ToshiyukiSano/iot-kicad-esp32c3-current-monitor/examples/current-monitor/hardware/README.md

# 回路・PCBデータの格納先

Claude CodeがUbuntuで作成した `.kicad_sch`、`.kicad_pcb`、`.kicad_pro`、専用 `.kicad_sym`、`.pretty`、ライブラリテーブル等をコピーする場所です。

**現時点では実ファイルが未提供**のため同梱していません。`scripts/import_local_project.sh` で取り込み、別環境で開けることを確認してください。Gerber/製造データはまだ作らないでください。
