ToshiyukiSano/iot-kicad-esp32c3-current-monitor/examples/current-monitor/firmware/README.md

# Arduinoスケッチの格納先

Claudeが作成した `firmware/current_monitor/current_monitor.ino` は、ユーザーのUbuntu上に存在すると報告されていますが、この会話には実ファイルが提供されていません。実際にコンパイル済みと確認できるまでは**未検証コード**と表示してください。

`bash scripts/import_local_project.sh ~/Projects/current-monitor` を使用すると、存在するファイルだけをここへコピーできます。
