ToshiyukiSano/iot-kicad-esp32c3-current-monitor/examples/current-monitor/hardware/final-check-from-claude.md

# current-monitor 製造前最終確認（2026-11-01）

対象：`current-monitor.kicad_pcb` / `current-monitor.kicad_sch`（配線は変更していない。U1 の 3D モデル情報のみ追加）

## 1. 検査結果

| 項目 | 結果 | 方法 |
|---|---|---|
| ERC | エラー 0 / 警告 0 | `kicad-cli sch erc --severity-all` |
| DRC | 違反 0 / 未接続 0 | `kicad-cli pcb drc --severity-all`（除外設定なし） |
| 回路図⇔PCB 整合 | Footprint errors 0 | DRC `--schematic-parity` |
| XIAO ピン配置 | 14/14 一致（位置誤差 0.004 mm） | U1 パッド座標 ⇔ Seeed 公式 XIAO ESP32C3 v1.3 PCB の同位置パッドのネット名 ⇔ シンボルのピン名 ⇔ 本PCBのネット |
| 3D モデル追加による配線・配置への影響 | なし | 追加前後で配線・ビア・部品位置のハッシュ一致 |
| D2 | DNP 維持（回路図・PCB・BOM） | |

### XIAO ピン照合

| U1 パッド | Seeed PCB ネット | シンボル | 本PCBネット |
|---|---|---|---|
| 1 | D0 | D0/A0/GPIO2 | D0_GPIO2 |
| 2 | D1 | D1/A1/GPIO3 | ADC_A1 |
| 3–6 | D2–D5 | D2–D5 | D2_GPIO4 … D5_GPIO7 |
| 7 | TX_D6 | D6/TX/GPIO21 | D6_GPIO21 |
| 8 | RX_D7 | D7/RX/GPIO20 | D7_GPIO20 |
| 9–11 | D8–D10 | D8–D10 | D8_GPIO8 … D10_GPIO10 |
| 12 | VCC_3V3 | 3V3 | +3V3 |
| 13 | GND | GND | GND |
| 14 | VUSB | 5V | 未接続（意図通り） |

### 実装・干渉確認（3D、PCB 上面を z=0）

| 部位 | 高さ / 位置 | 判定 |
|---|---|---|
| ソケット（1x07 ×2） | 本体高 8.50 mm（KiCad モデル） | パッド列上に正しく配置 |
| XIAO 基板下面 | 11.04 mm（ソケット 8.50 + ヘッダー樹脂 2.54） | XIAO 下の本PCBには配線・ビアのみ（部品なし） |
| XIAO USB-C | 上端 16.37 mm、前端は基板上辺から 1.0 mm 外側 | 下に背の高い部品なし。プラグは基板外側に挿入 → 干渉なし |
| XIAO U.FL | XIAO の USB 反対端中央、PCB 座標 ≈(139.0, 120.1)、上端 13.89 mm | 最寄りの J4（ピン上端 8.65 mm、15 mm 離れ）・J1（28 mm 離れ）と干渉なし |
| J1 端子台 | 高さ 13.8 mm（KiCad モデル）、電線口は左辺、前面は基板端から 0.9 mm 内側 | USB・アンテナとは反対側 |
| J4 ピンヘッダー | ピン上端 8.65 mm、XIAO 下端から 12 mm 離れ | 相手コネクタを挿しても XIAO と干渉しない見込み |
| 全高 | 約 16.4 mm（USB 上端）、裏面は THT リード 3.1〜3.5 mm | 筐体設計時に要考慮 |

**XIAO の 3D モデルは近似モデル**：Seeed 公式 STEP は GrabCAD 経由のみ（ログイン必須、取得試行は HTTP 403）で取得できなかった。
Seeed 公式 KiCad PCB（v1.3）から外形・USB/U.FL/ESP32-C3 の位置を取り、KiCad 標準モデル（U.FL は同一型番 Hirose U.FL-R-SMT-1、USB-C は GCT USB4105 で代用、QFN-32）を置いて STEP を生成した（`tools/make_xiao_model.py`）。板厚 1.6 mm は Seeed ファイルの値（KiCad 既定値で、実寸未確認）。ボタン・LED・受動部品は省略。

## 2. 未解決事項

1. **電源 OFF 時の逆給電（未解決）**：XIAO 無電源で CT に電流が流れると BAT54S 上側ダイオード経由で 3V3 系へ流入。R1 正常・80 A で最大約 80 µA、R1 断線時約 1.5 mA。ESP32-C3 データシートに GPIO の絶対最大定格・注入電流の規定がなく、安全とは判断できない。
2. **CT 開放時の安全性（未解決）**：J1 が外れると基板側 R1・D2 は切り離され、CT 内蔵 7.5 V ツェナーのみが保護。ツェナーの電力定格・連続開放の可否は仕様書に記載なし。運用で「一次通電中に J1 を外さない」ことが必要。
3. D2（TVS）は DNP。実装する場合は 1 V 以下での漏れ電流を実測してから。
4. XIAO 3D モデルが近似（上記）。XIAO の板厚・USB-C 実部品（UBF31-0171）の形状・高さは未確認。
5. ソケット高 8.5 mm・ヘッダー樹脂 2.54 mm は KiCad モデル値。購入品の寸法で再確認が必要。XIAO にピンヘッダーが付属するかは未確認。
6. USB プラグ外形、アンテナケーブル・アンテナ本体の取付位置、筐体との干渉は未確認。
7. J1 の電線口の向きは KiCad の 3D モデルと慣例に基づく（Phoenix の外形図とは未照合）。
8. BOM の型番はすべて候補。在庫・価格・最新状態は未確認（BAT54S-7-F と Phoenix 1715721 は型番自体をデータシートで確認済み）。
9. C3 は XIAO ピン直近ではなくアナログ部入口に配置。
10. 3V3 の B.Cu ジャンパー（12 mm）による B 面 GND のスリット（ADC 配線直下ではない）。
11. 5 A 以下の分解能、ADC ゲイン校正、ESP32-C3 ADC ノイズ量。
12. スクリプト運用：`tools/build_pcb.py --force` → `tools/route_pcb.py` → `tools/set_u1_models.py` の順で再生成される。GUI で手修正後は実行しない。

## 3. 低電圧模擬電流による試験手順（50/60 Hz）

**安全上の前提**：商用電源の電線を CT に通す試験は行わない。一次電流は絶縁された低電圧交流源（絶縁トランスの二次側、またはファンクションジェネレータ＋電力増幅器）から供給する。XIAO を PC の USB に接続する場合、試験機器のアースと本基板 GND がつながるとループになるため、信号注入はフローティング（電池駆動または絶縁）で行う。J1.2 は VBIAS（1.65 V）であり GND ではない。

### 準備
- 機材：真の実効値 DMM（一次電流測定用）、オシロスコープ（差動プローブ推奨）、絶縁低電圧 AC 源（50 Hz・60 Hz）、電力抵抗負荷、ファンクションジェネレータ（フローティング）、µA 計。
- 一次電流は電線を CT に N 回巻いて増やす（等価電流 = N × 一次電流）。例：5 A × 16 回 = 80 A 相当。

### 手順
1. **実装前検査**：R1 両端（J1.1–J1.2）が 10 Ω、3V3–GND 間に短絡なし、D2 未実装、U1 ソケット向き（ピン 1 = USB 側）を目視確認。
2. **無信号・CT 未接続**：XIAO を USB 給電。3V3、VBIAS（期待値 1.65 V ±約 0.03 V）、ADC_A1 の DC 電圧を測定。ファームウェアで ADC 平均値を記録。
3. **ノイズフロア**：CT を接続し一次電流 0。100 ms（50/60 Hz 共に整数周期）ごとに平均除去後の RMS を算出し、Wi-Fi 停止時と連続送信時で比較。
4. **信号注入（CT なし）**：フローティングのジェネレータを直列 1 kΩ 経由で J1 に接続（1 Vrms → R1 に 1 mA ≒ CT 一次 3 A 相当）。50 Hz と 60 Hz で ADC RMS を記録。
5. **周波数特性**：同じ注入で 50, 60, 150, 250, 650, 1000 Hz を測定し、期待値（振幅比 0.989, 0.985, 0.914, 0.805, 0.462, 0.321）と比較。
6. **CT 実電流**：絶縁 AC 源 → 負荷 → CT（N 回巻き）で等価 1, 5, 10, 20, 80 A を通電。一次電流を DMM で測り、ADC 換算値と比較。

   | 等価一次電流 | 二次電流 | R1 電圧 rms | ADC 入力範囲 |
   |---|---|---|---|
   | 1 A | 0.33 mA | 3.3 mV | 1.645–1.655 V |
   | 5 A | 1.67 mA | 16.7 mV | 1.626–1.674 V |
   | 10 A | 3.33 mA | 33.3 mV | 1.60–1.70 V |
   | 20 A | 6.67 mA | 66.7 mV | 1.56–1.74 V |
   | 80 A | 26.7 mA | 267 mV | 1.27–2.03 V |

   誤差・直線性・50/60 Hz 差を記録し、ゲイン校正係数を決定。
7. **クランプ確認**：ジェネレータ注入レベルを上げ、ADC_A1 が 3V3 + 約 0.3 V、GND − 約 0.3 V でクランプされることをオシロで確認（ESP32-C3 の GPIO 定格が未規定のため短時間で）。
8. **電源 OFF 時の流入電流**：XIAO の USB を外し、3V3 ラインに µA 計を入れられる治具で、注入レベルごとの流入電流を測定（未解決事項 1 の評価用）。
9. **CT 二次側開放での通電試験は禁止**（2026-11-01 決定）。CT リードは必ず J1 に締結してから一次側を通電し、巻数変更・取り外しは一次側を遮断してから行う。
10. **記録**：各条件の一次電流、ADC 平均・RMS、Wi-Fi 状態、周囲温度。
