ToshiyukiSano/iot-kicad-esp32c3-current-monitor/examples/current-monitor/hardware/current-monitor.kicad_pcb

## KiCad design examples/current-monitor/hardware/current-monitor.kicad_pcb (2026-10-31)

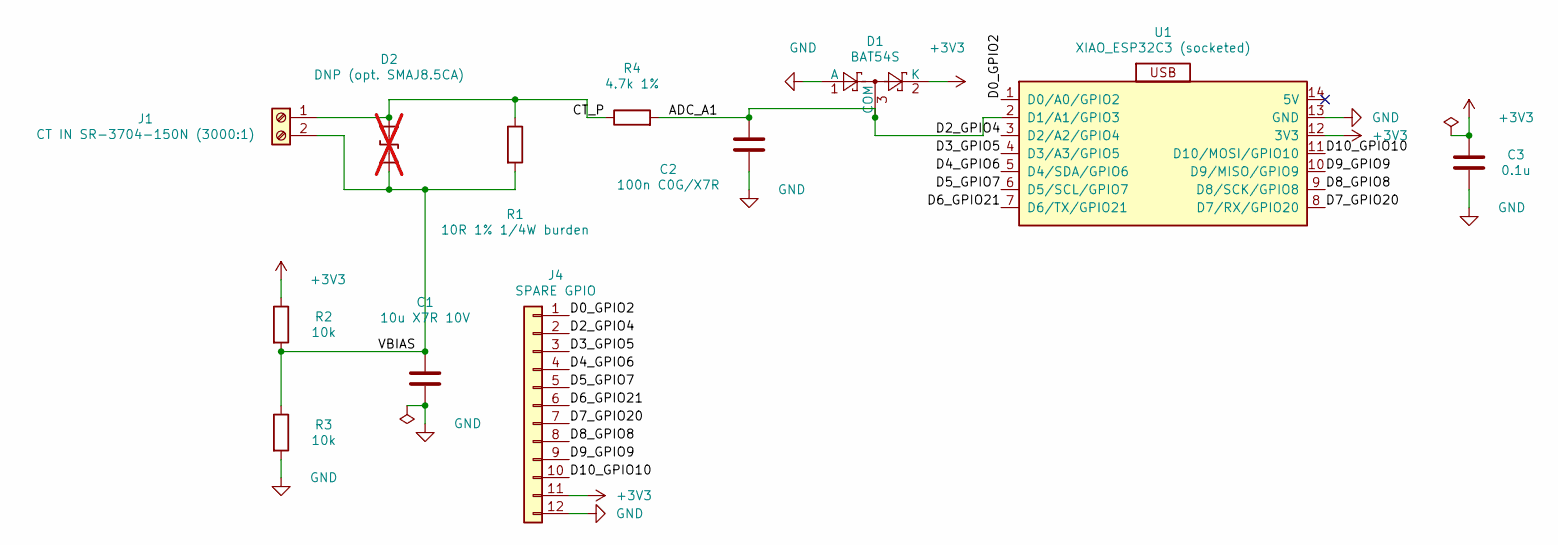
[picture p3: schematic current-monitor.kicad_sch]

Parts:
C1: 10u X7R 10V; C_0805_2012Metric
C2: 100n C0G/X7R; C_0805_2012Metric
C3: 0.1u; C_0603_1608Metric
D1: BAT54S; SOT-23
D2: DNP (opt. SMAJ8.5CA); D_SMA; not fitted
J1: CT IN SR-3704-150N (3000:1); TerminalBlock_Phoenix_MKDS-1,5-2-5.08_1x02_P5.08mm_Horizont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
J4: SPARE GPIO; PinHeader_1x12_P2.54mm_Vertical
R1: 10R 1% 1/4W burden; R_1206_3216Metric
R2, R3: 10k; R_0603_1608Metric
R4: 4.7k 1%; R_0603_1608Metric
U1: XIAO_ESP32C3 (socketed); XIAO_ESP32C3_Socket_2x07_P2.54mm_Row15.24mm

Connections:
+3V3: C3.1, D1.2 (K), J4.11, R2.1, U1.12 (3V3)
/ADC_A1: C2.1, D1.3 (COM), R4.2, U1.2 (D1/A1/GPIO3)
/CT_P: D2.1 (A1), J1.1, R1.1, R4.1
/D0_GPIO2: J4.1, U1.1 (D0/A0/GPIO2)
/D2_GPIO4: J4.2, U1.3 (D2/A2/GPIO4)
/D3_GPIO5: J4.3, U1.4 (D3/A3/GPIO5)
/D4_GPIO6: J4.4, U1.5 (D4/SDA/GPIO6)
/D5_GPIO7: J4.5, U1.6 (D5/SCL/GPIO7)
/D6_GPIO21: J4.6, U1.7 (D6/TX/GPIO21)
/D7_GPIO20: J4.7, U1.8 (D7/RX/GPIO20)
/D8_GPIO8: J4.8, U1.9 (D8/SCK/GPIO8)
/D9_GPIO9: J4.9, U1.10 (D9/MISO/GPIO9)
/D10_GPIO10: J4.10, U1.11 (D10/MOSI/GPIO10)
/VBIAS: C1.1, D2.2 (A2), J1.2, R1.2, R2.2, R3.1
GND: C1.2, C2.2, C3.2, D1.1 (A), J4.12, R3.2, U1.13 (GND)

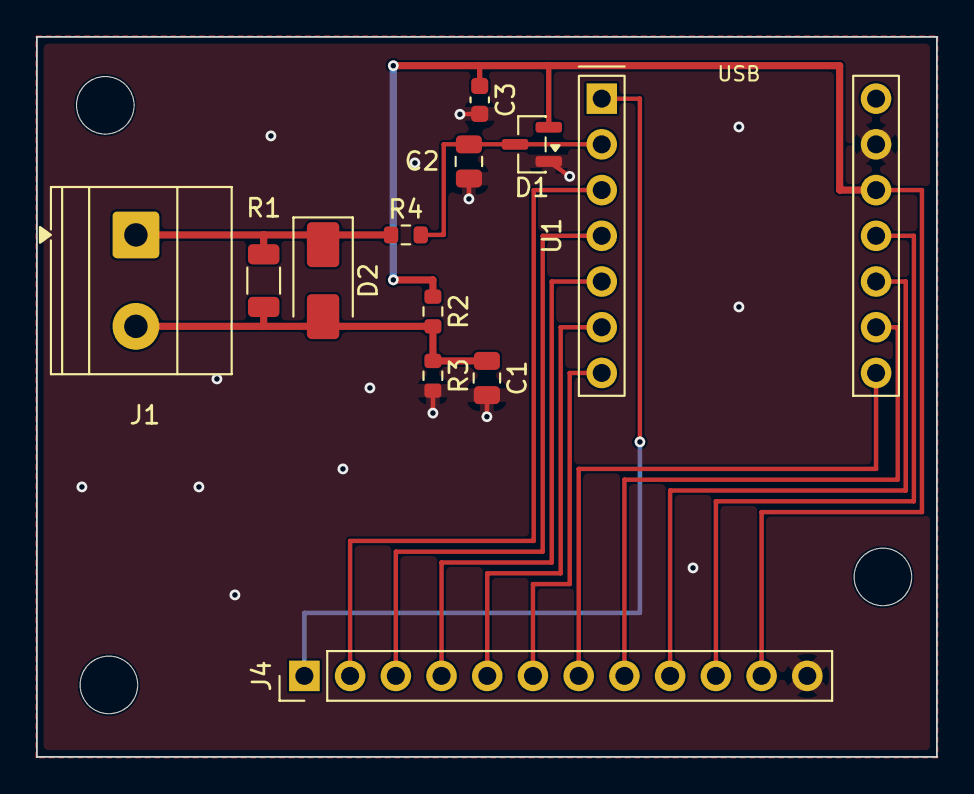
[picture p4: board current-monitor.kicad_pcb from above]

Board: 2 copper layers, 50.0 x 40.0 mm, 15 parts (0 on the bottom side), 15 nets.

Other parts of the board:
H1, H2, H3: M3; MountingHole_3.2mm_M3
