ToshiyukiSano/iot-kicad-esp32c3-current-monitor/(commit log)

2026-10-31 docs: add AI-assisted KiCad IoT hardware development guide
    [bom-candidates.csv, bom-from-claude.csv, current-monitor.kicad_pcb, current-monitor.kicad_sch]
2026-10-31 docs: add PCBA manufacturing and cost guide
